onlinelaser/olc-flexshield/Flexible Frame Full Face.dxf

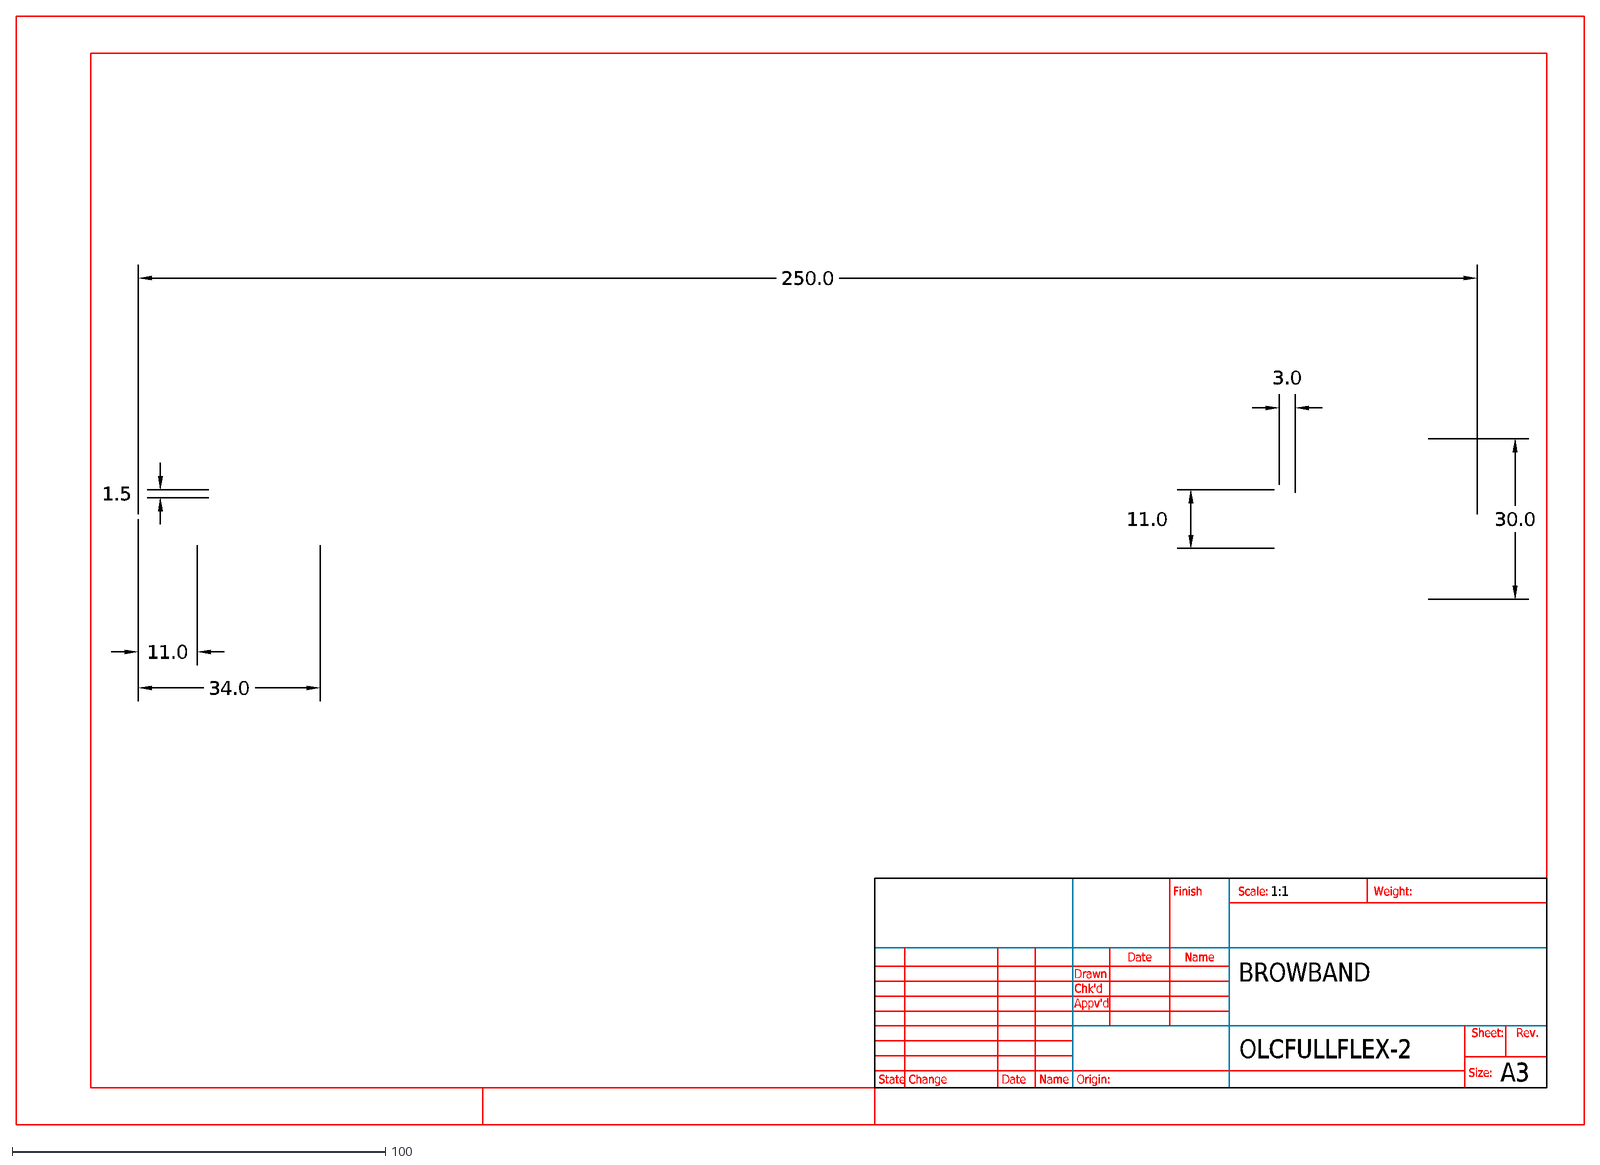
[picture p1: CAD file, 2020-04-27]
Flexible Frame Full Face.dxf
OLCFULLFLEX-2
BROWBAND
1:1
A3
State
Drawn
Appv'd
Name
Origin:
Chk'd
Date
Change
Finish
Scale:
Weight:
Sheet:
Size:
Rev.
250.0
30.0
11.0
34.0
3.0
1.5
